bullochr/ME330/RoverCircuit/RoverCircuit.csv

Reference | Qty | Value | DNP | Exclude from BOM | Exclude from Board | Footprint | Datasheet
3.3V_Reg_In2,3.3V_Reg_Out2,5V_Reg_In1,5V_Reg_Out1,Battery1 | 5 | Battery_Terminal |  |  |  | Custom_Library:screw_terminal | ~
C1,C2,C6,C7,C8,C9,C10,C11,C12,C13,C14 | 11 | 0.1uF |  |  |  | Capacitor_THT:C_Disc_D3.4mm_W2.1mm_P2.50mm | ~
C3,C4,C15 | 3 | 100uF |  |  |  | Capacitor_THT:CP_Radial_D7.5mm_P2.50mm | ~
D1,D2 | 2 | LED |  |  |  | LED_THT:LED_D8.0mm | ~
D4 | 1 | Sample_Photodiode |  |  | Excluded from board |  | ~
D5 | 1 | Satellite_Photodiode |  |  | Excluded from board |  | ~
J1_Servo1,J6_Left_Sharp1,J7_Right_Sharp1,J8_Front_Sharp1,J15_Ball_QRD1 | 5 | JST_3Pin_P2.54_V |  |  |  | Connector_JST:JST_EH_B3B-EH-A_1x03_P2.50mm_Vertical | ~
J2_Left_Wheel1,J3_Right_Wheel1 | 2 | JST_4Pin_P2.54_V |  |  |  | Connector_JST:JST_EH_B4B-EH-A_1x04_P2.50mm_Vertical | ~
J4,J5 | 2 | JST_10Pin_P2.54_V |  |  |  | Connector_JST:JST_EH_B10B-EH-A_1x10_P2.50mm_Vertical | ~
J10 | 1 | JST_5Pin_P2.54_H |  |  | Excluded from board | Connector_JST:JST_EH_S5B-EH_1x05_P2.50mm_Horizontal | ~
J11_Sample_IR_Diode1,J12_Sat_Diode1,J13_Laser1 | 3 | JST_2Pin_P2.54_V |  |  |  | Connector_JST:JST_EH_B2B-EH-A_1x02_P2.50mm_Vertical | ~
J14_QRD_Board1 | 1 | JST_5Pin_P2.54_V |  |  |  | Connector_JST:JST_EH_B5B-EH-A_1x05_P2.50mm_Vertical | ~
LD1 | 1 | D_Laser_1C2A |  |  | Excluded from board |  | ~
Left_Wheel1 | 1 | Left_Wheel_Power_Terminal |  |  |  | Custom_Library:screw_terminal | ~
M1 | 1 | Motor_Servo |  |  | Excluded from board |  | http://forums.parallax.com/uploads/attachments/46831/74481.png
M2 | 1 | Left_Wheel |  |  | Excluded from board |  | http://www.infineon.com/dgdl/Application-Note-TLE8110EE_driving_UniPolarStepperMotor_V1.1.pdf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
M3 | 1 | Right_Wheel |  |  | Excluded from board |  | http://www.infineon.com/dgdl/Application-Note-TLE8110EE_driving_UniPolarStepperMotor_V1.1.pdf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
MP1,MP2 | 2 | MP6500 |  |  | Excluded from board
PIC_Barrel_Jack1 | 1 | PIC_Power_Terminal |  |  |  | Custom_Library:screw_terminal | ~
Q1 | 1 | VN2106 |  |  |  | Package_TO_SOT_THT:TO-92S | https://ngspice.sourceforge.io/docs/ngspice-html-manual/manual.xhtml#cha_MOSFETs
Q3,Q4,Q5,Q7 | 4 | QRD1114 |  |  | Excluded from board | Diode_THT:Diode_Bridge_DIP-4_W5.08mm_P2.54mm
R3,R4,R5 | 3 | 330Ω |  |  |  | Resistor_THT:R_Axial_DIN0207_L6.3mm_D2.5mm_P10.16mm_Horizontal | ~
R6,R7 | 2 | 1MΩ |  |  |  | Resistor_THT:R_Axial_DIN0207_L6.3mm_D2.5mm_P10.16mm_Horizontal | ~
R8,R9,R10 | 3 | 330Ω |  |  | Excluded from board | Resistor_THT:R_Axial_DIN0207_L6.3mm_D2.5mm_P10.16mm_Horizontal | ~
R11,R12,R13 | 3 | 10kΩ |  |  | Excluded from board | Resistor_THT:R_Axial_DIN0207_L6.3mm_D2.5mm_P10.16mm_Horizontal | ~
R14,R15,R16,R17,R18,R19,R20,R21,R22,R23,R24 | 11 | 10kΩ |  |  |  | Resistor_THT:R_Axial_DIN0207_L6.3mm_D2.5mm_P10.16mm_Horizontal | ~
Right_Wheel1 | 1 | Right_Wheel_Terminal |  |  |  | Custom_Library:screw_terminal | ~
S1 | 1 | Left_Sharp_Sensor |  |  | Excluded from board
S2 | 1 | Right_Sharp_Sensor |  |  | Excluded from board
S3 | 1 | Front_Sharp_Sensor |  |  | Excluded from board
U1 | 1 | PIC24F16KA301 |  |  | Excluded from board
U2 | 1 | 5v Reg |  |  | Excluded from board
U3 | 1 | LM324 |  |  |  | Package_DIP:DIP-14_W7.62mm | http://www.ti.com/lit/ds/symlink/lm2902-n.pdf
U4 | 1 | 3.3v Reg |  |  | Excluded from board
