bullochr/ME330/QRD_Circuit/QRD_Circuit.step

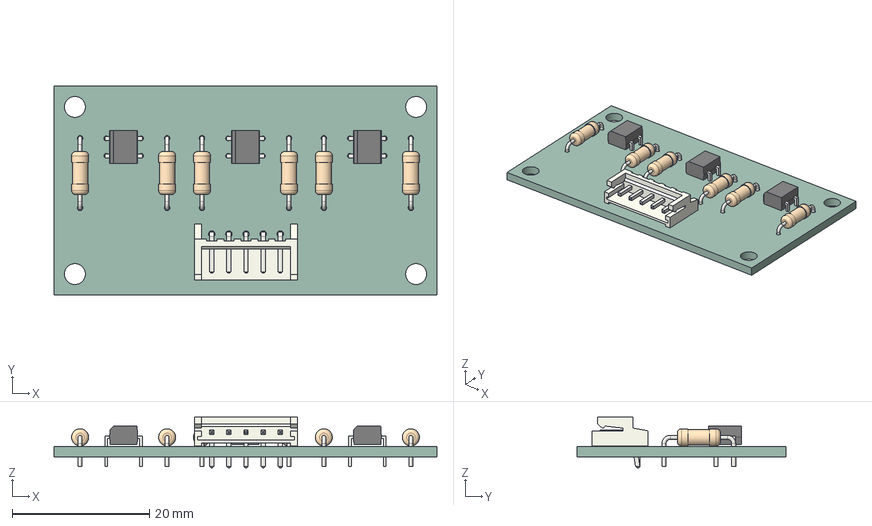
[picture p1: CAD file, 2026-10-22]
QRD_Circuit/QRD_Circuit.step
55.9 x 30.5 x 7.40 mm
Diode_Bridge_DIP-4_W5.08mm_P2.54mm x 3
R_Axial_DIN0207_L6.3mm_D2.5mm_P10.16mm_Horizontal x 6
JST_EH_S5B-EH_1x05_P2.50mm_Horizontal
QRD_Circuit_PCB
