bullochr/ME330/RoverCircuit/RoverCircuit.step

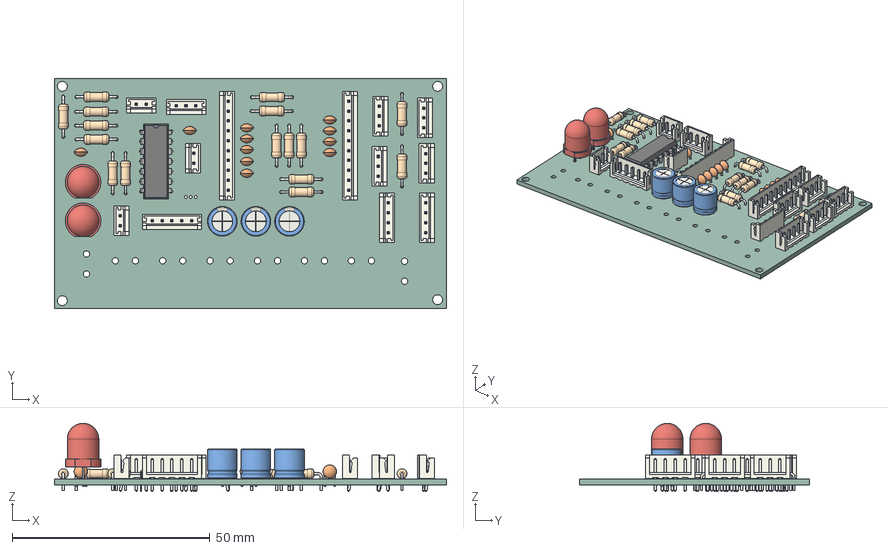
[picture p2: CAD file, 2026-11-01]
RoverCircuit/RoverCircuit.step
99.2 x 58.2 x 17.3 mm
R_Axial_DIN0207_L6.3mm_D2.5mm_P10.16mm_Horizontal x 16
CP_Radial_D7.5mm_P2.50mm x 3
JST_EH_B2B-EH-A_1x02_P2.50mm_Vertical x 3
C_Disc_D3.4mm_W2.1mm_P2.50mm x 11
JST_EH_B10B-EH-A_1x10_P2.50mm_Vertical x 2
LED_D8.0mm x 2
JST_EH_B3B-EH-A_1x03_P2.50mm_Vertical x 5
JST_EH_B4B-EH-A_1x04_P2.50mm_Vertical x 2
DIP-14_W7.62mm
JST_EH_B5B-EH-A_1x05_P2.50mm_Vertical
RoverCircuit_PCB
