bullochr/ME330/RoverCircuit/RoverCircuitDiagram10_30.pdf

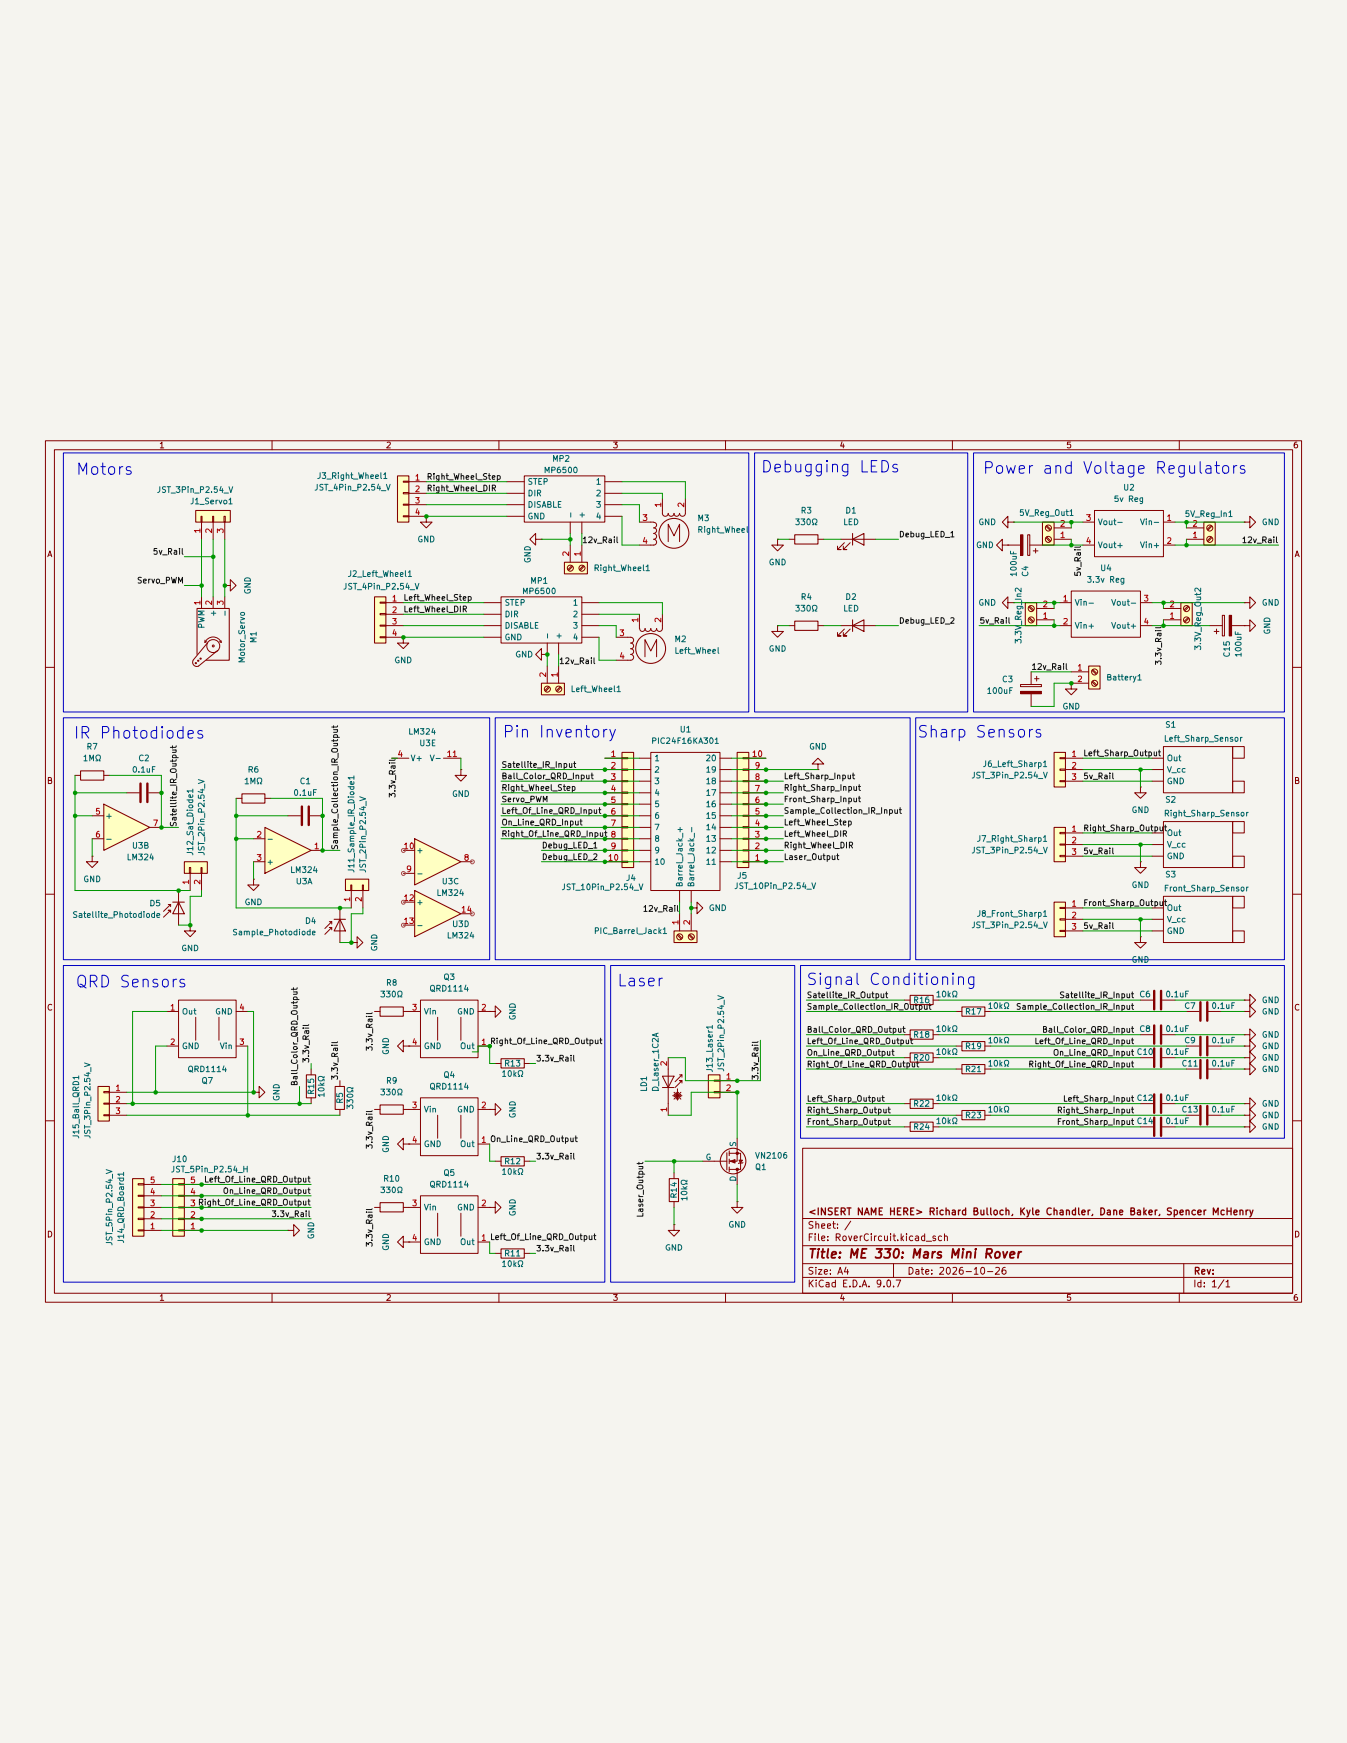
[picture p3: page 1]
