bullochr/ME330/RoverCircuit/RoverCircuitDiagram10_24.pdf

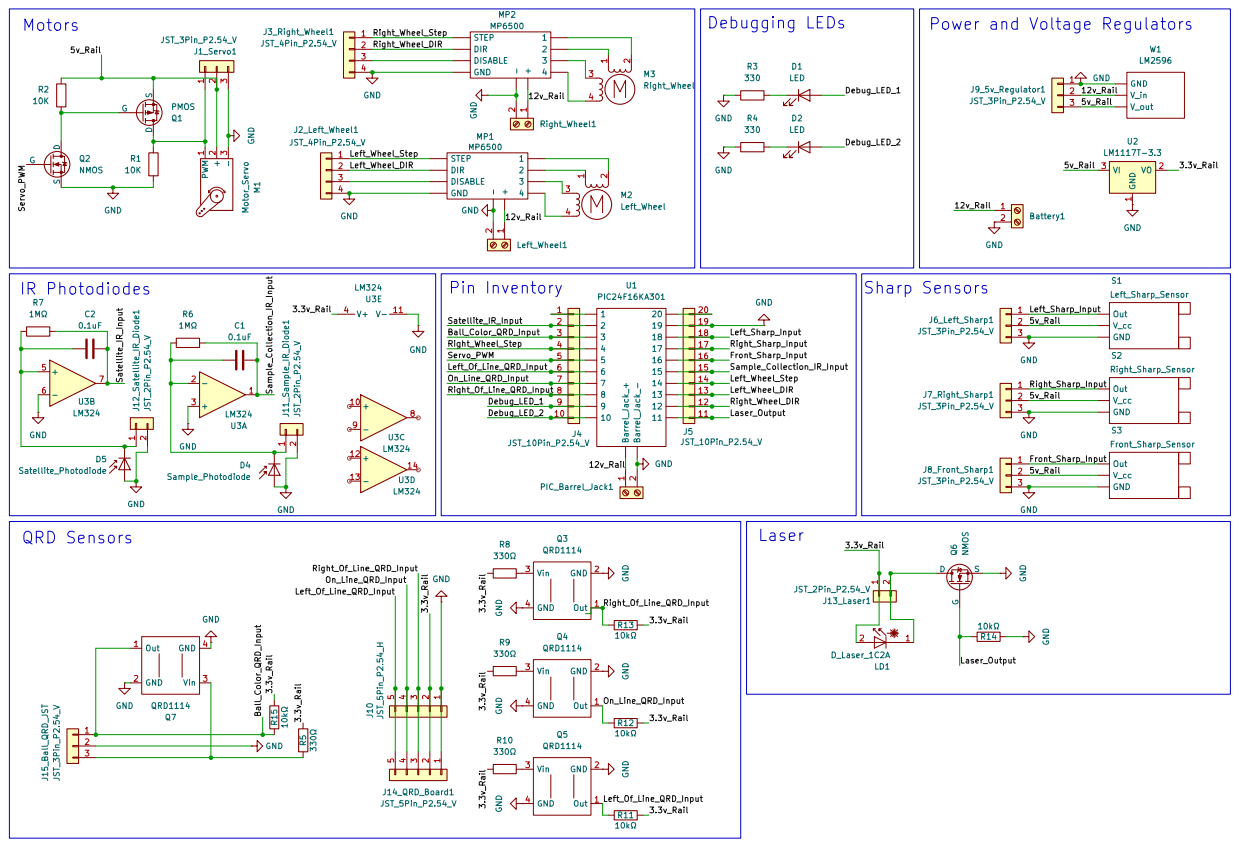
[picture p4: page 1]
