bullochr/ME330/RoverCircuit/RoverCircuit.kicad_pcb

## KiCad design RoverCircuit/RoverCircuit.kicad_pcb (2026-11-01)

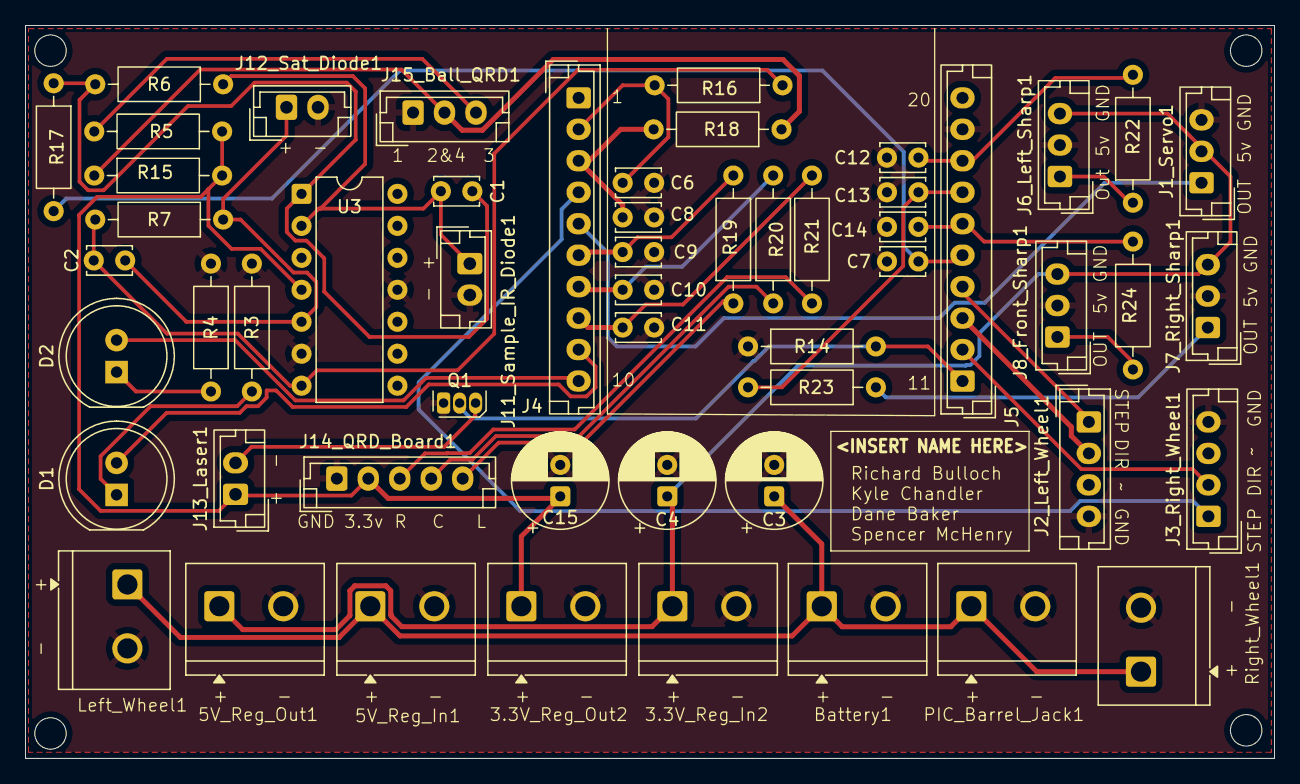
[picture p5: board RoverCircuit.kicad_pcb from above]

Board: 2 copper layers, 99.2 x 58.2 mm, 55 parts (0 on the bottom side), 36 nets.

Parts:
3.3V_Reg_In2, 3.3V_Reg_Out2, 5V_Reg_In1, 5V_Reg_Out1: Battery_Terminal; screw_terminal
Battery1: Battery_Terminal; screw_terminal
C1, C2, C6, C7, C8, C9, C10, C11, C12, C13, C14: 0.1uF; C_Disc_D3.4mm_W2.1mm_P2.50mm
C3, C4, C15: 100uF; CP_Radial_D7.5mm_P2.50mm
D1, D2: LED; LED_D8.0mm
J1_Servo1, J6_Left_Sharp1, J7_Right_Sharp1, J8_Front_Sharp1, J15_Ball_QRD1: JST_3Pin_P2.54_V; JST_EH_B3B-EH-A_1x03_P2.50mm_Vertical
J2_Left_Wheel1, J3_Right_Wheel1: JST_4Pin_P2.54_V; JST_EH_B4B-EH-A_1x04_P2.50mm_Vertical
J4, J5: JST_10Pin_P2.54_V; JST_EH_B10B-EH-A_1x10_P2.50mm_Vertical
J11_Sample_IR_Diode1, J12_Sat_Diode1, J13_Laser1: JST_2Pin_P2.54_V; JST_EH_B2B-EH-A_1x02_P2.50mm_Vertical
J14_QRD_Board1: JST_5Pin_P2.54_V; JST_EH_B5B-EH-A_1x05_P2.50mm_Vertical
Left_Wheel1: Left_Wheel_Power_Terminal; screw_terminal
PIC_Barrel_Jack1: PIC_Power_Terminal; screw_terminal
Q1: VN2106; TO-92S
R3, R4, R5: 330Ω; R_Axial_DIN0207_L6.3mm_D2.5mm_P10.16mm_Horizontal
R6, R7: 1MΩ; R_Axial_DIN0207_L6.3mm_D2.5mm_P10.16mm_Horizontal
R14, R15, R16, R17, R18, R19, R20, R21, R22, R23, R24: 10kΩ; R_Axial_DIN0207_L6.3mm_D2.5mm_P10.16mm_Horizontal
Right_Wheel1: Right_Wheel_Terminal; screw_terminal
U3: LM324; DIP-14_W7.62mm

Connections:
/3.3v_Rail: 3.3V_Reg_Out2.1, C15.1, J13_Laser1.1, J14_QRD_Board1.2, R5.1, R15.2, U3.4 (V+)
/5v_Rail: 3.3V_Reg_In2.1, 5V_Reg_Out1.1, C4.1, J1_Servo1.2, J6_Left_Sharp1.3, J7_Right_Sharp1.3, J8_Front_Sharp1.3
/12v_Rail: 5V_Reg_In1.1, Battery1.1, C3.1, Left_Wheel1.1, PIC_Barrel_Jack1.1, Right_Wheel1.1
/Ball_Color_QRD_Input: C8.1, J4.3, R18.2
/Ball_Color_QRD_Output: J15_Ball_QRD1.2, R15.1, R18.1
/Debug_LED_1: D1.2 (A), J4.9
/Debug_LED_2: D2.2 (A), J4.10
/Front_Sharp_Input: C14.1, J5.6, R24.2
/Front_Sharp_Output: J8_Front_Sharp1.1, R24.1
/Laser_Output: J5.1, Q1.2 (G), R14.2
/Left_Of_Line_QRD_Input: C9.1, J4.6, R19.2
/Left_Of_Line_QRD_Output: J14_QRD_Board1.5, R19.1
/Left_Sharp_Input: C12.1, J5.8, R22.2
/Left_Sharp_Output: J6_Left_Sharp1.1, R22.1
/Left_Wheel_DIR: J2_Left_Wheel1.2, J5.3
/Left_Wheel_Step: J2_Left_Wheel1.1, J5.4
/On_Line_QRD_Input: C10.1, J4.7, R20.2
/On_Line_QRD_Output: J14_QRD_Board1.4, R20.1
/Right_Of_Line_QRD_Input: C11.1, J4.8, R21.2
/Right_Of_Line_QRD_Output: J14_QRD_Board1.3, R21.1
/Right_Sharp_Input: C13.1, J5.7, R23.2
/Right_Sharp_Output: J7_Right_Sharp1.1, R23.1
/Right_Wheel_DIR: J3_Right_Wheel1.2, J5.2
/Right_Wheel_Step: J3_Right_Wheel1.1, J4.4
/Sample_Collection_IR_Input: C7.1, J5.5, R17.2
/Sample_Collection_IR_Output: C1.2, R6.2, R17.1, U3.1
/Satellite_IR_Input: C6.1, J4.2, R16.2
/Satellite_IR_Output: C2.2, R7.2, R16.1, U3.7
/Servo_PWM: J1_Servo1.1, J4.5
GND: 3.3V_Reg_In2.2, 3.3V_Reg_Out2.2, 5V_Reg_In1.2, 5V_Reg_Out1.2, Battery1.2, C3.2, C4.2, C6.2, C7.2, C8.2, C9.2, C10.2, C11.2, C12.2, C13.2, C14.2, C15.2, J1_Servo1.3, J2_Left_Wheel1.4, J3_Right_Wheel1.4, J5.9, J6_Left_Sharp1.2, J7_Right_Sharp1.2, J8_Front_Sharp1.2, J11_Sample_IR_Diode1.2, J12_Sat_Diode1.2, J14_QRD_Board1.1, J15_Ball_QRD1.1, Left_Wheel1.2, PIC_Barrel_Jack1.2, Q1.1 (D), R3.1, R4.1, R14.1, Right_Wheel1.2, U3.3 (+), U3.6 (-), U3.11 (V-)
unnamed: D1.1 (K), R3.2
unnamed: D2.1 (K), R4.2
unnamed: C1.1, J11_Sample_IR_Diode1.1, R6.1, U3.2 (-)
unnamed: C2.1, J12_Sat_Diode1.1, R7.1, U3.5 (+)
unnamed: J13_Laser1.2, Q1.3 (S)
unnamed: J15_Ball_QRD1.3, R5.2
