bullochr/ME330/(commit log)

2026-10-07 Added framework for driving and turning
    Added state variables for wheel displacement and target
    Added global constants related to the robot's hardware
    Added function for getting nuber of steps to go a distance and for turning 90 degrees
2026-10-08 Added header files and driving functionality
    still needs values for a few global variables and pin assignments for stepper direction
2026-10-10 Added pin assignments and DIR pins for driving
    Also refactored interrupt architecture to include a flag struct that holds flags that can be reacted to in the updateState function
2026-10-15 Added KiCad Project
    also removed extra define statements
2026-10-18 Added Servo and Stepper Motors to circuit schematic
2026-10-19 Added pinout and voltage rails
    Configured pins in MPLAB and added net labels for each pin in KiCad
2026-10-20 Updated pin config to include the full pin inventory
2026-10-20 Added simple line following logic
    speeds up left wheel when too far left, and right heel when too far right
2026-10-20 Added functions for LED debugging
    including writing 4 bit values and error messages, as well as individual LED control
2026-10-20 Added Sharp Sensors to KiCad
2026-10-20 changed pin 11 from debug LED to laser
2026-10-22 Finalized rover circuit schematic, first version of QRD circuit
    rover circuit layout and traces not finished yet
2026-10-23 Saved circuit diagram as a pdf
2026-10-24 Implemented proportional control, with framework to include PID
    added AD_config, organized other config headers, including separating PWM_config into its own header
2026-10-26 Added low pass filters on every analog input
    Used R=150, C=0.1uF to attenuate frequencies above the frequency of how fast the AD converter will read each signal.
2026-10-27 Added signal conditioning and reorganized the PCB
    Also added bulk capacitors on each power rail
2026-10-27 Added I/O tests and organized config
    added defines for I/O registers
    updated AD_config for input from all sensors
2026-10-27 Fixed datatype operator bug
    difference between left and right sensors is now an int
2026-10-31 Finalized circuit diagram, functional line following
2026-11-01 added mounting holes to pcb
2026-11-09 Initial Canyon Navigation
    I added the initial code for the canyon navigation milestone. It is kind of difficult to troubleshoot without the mounts for it, so waiting on the new base.
